terrill-17/creations/_template/bom.csv

item | qty | unit | spec | source | url | unit_cost | currency | total | notes
M4x12 socket head screw | 8 | pcs | ISO 4762 stainless | McMaster |  | 0.20 | USD | 1.60
