terrill-17/creations/(list of files, cad)

Other CAD files:
coffee-machine/exports/lc_spacer.stl
coffee-machine/exports/carafe_platform.stl
coffee-machine/exports/drip_grate.stl
coffee-machine/exports/pump_cradle.stl
coffee-machine/exports/cone_lc_mount.stl
coffee-machine/exports/kettle_platform.stl
coffee-machine/exports/v60_holder.stl
coffee-machine/exports/trim_heater_block_bottom.step
coffee-machine/exports/trim_heater_block_preview.stl
coffee-machine/exports/trim_heater_block_top.step
coffee-machine/exports/drip_tray.stl
coffee-machine/exports/electronics_tray.stl
