terrill-17/creations/coffee-machine/images/assembly_internals.png

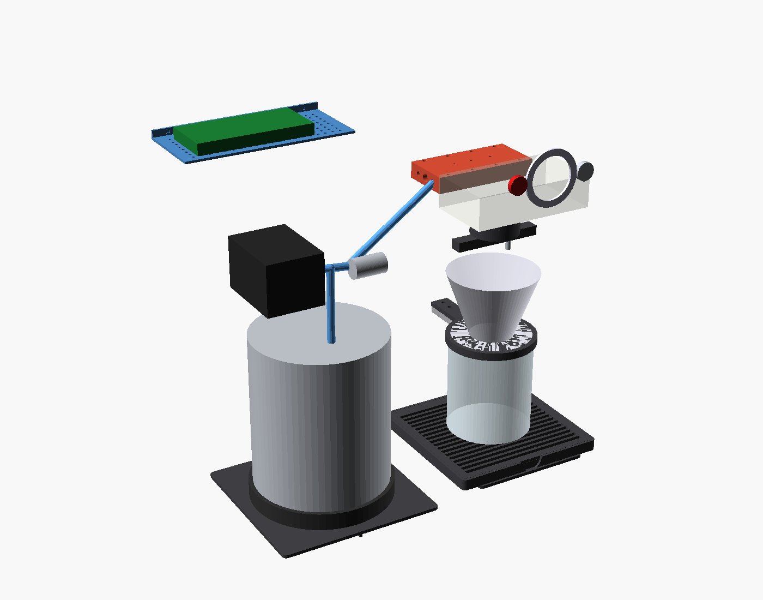
coffee-machine/images/assembly_internals.png
