terrill-17/creations/(commit log)

2026-11-07 Initial structure: project template, README, LFS and gitignore
    Claude-Session: https://claude.ai/code/session_01TaKuEZ3AP9XCCXFB5v93CF
    [bom.csv, model.scad]
2026-11-07 Add coffee-machine project from template
    Claude-Session: https://claude.ai/code/session_01TaKuEZ4t4MxTB6H2WfYEDp
    [bom.csv, model.scad]
2026-11-07 coffee-machine: draft 1 layout, printed inserts, heater block, BOM
    Automatic pour-over brewer around a V60-02 insert: kettle side bay,
    brew bay with carafe/cone/kettle scales, 24 V trim heater block (CadQuery
    STEP for CNC), PA12 printed inserts (OpenSCAD), exports/build.sh to
    regenerate everything, BOM with estimated costs, and build notes.
    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
    [assembly.scad, bom.csv, carafe_platform.stl, cone_lc_mount.stl, drip_grate.stl, drip_tray.stl, electronics_tray.stl, kettle_platform.stl]
